TManish011/eYSIP_2015_Two_Wheel_Balance_Bot/README.md

# eYSIP_2015_Two_Wheel_Balance_Bot
Development of a self balancing two wheel bot using PID and IMU

The previous commits can be found at
[https://github.com/eySIP-balance-bot](https://github.com/eySIP-balance-bot)
