TManish011/eYSIP_2015_Two_Wheel_Balance_Bot/Application/Scilab/README.md

# Scilab

Real Time Plot and GUI for balance bot
--------------------------------------
PC Controlled Two Wheel Balanced Bot
------------------------------------
eYSIP-2015        
Author List: B Suresh, Ramiz Hussain, Devendra Kr Jangid     
Mentors: Piyush Manavar, Saurav Shandilya

A Scilab Interface was built for the purpose of tuning and controlling the 2 wheel Balance Bot
