TManish011/eYSIP_2015_Two_Wheel_Balance_Bot/Research/Balance-bot-1/Progress-Presentation/Progress-Presentation.pdf

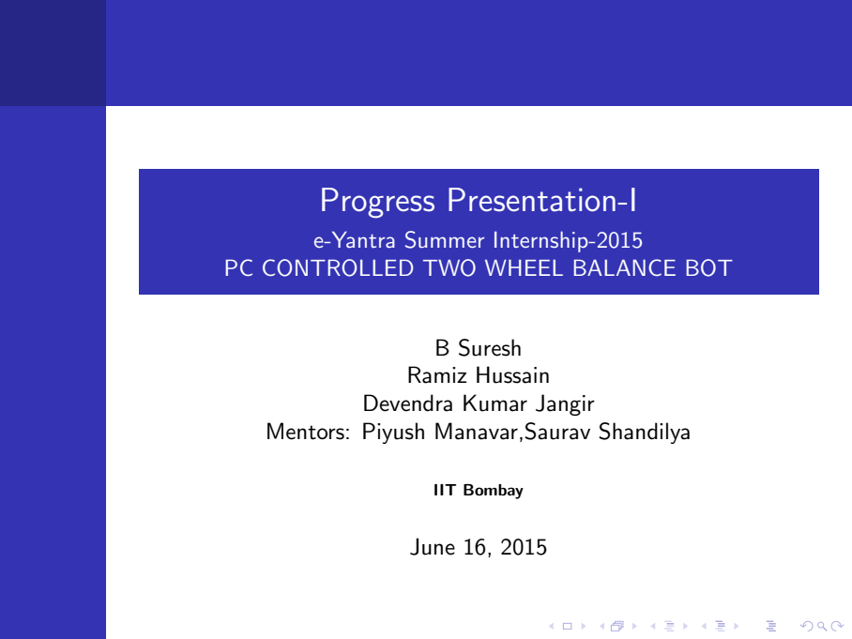
[picture p14: figure]
Progress Presentation-I; e-Yantra Summer Internship-2015 PC CONTROLLED TWO WHEEL BALANCE BOT; B Suresh Ramiz Hussain Devendra Kumar Jangir; IIT Bombay; June 16, 2015

# Mentors: Piyush Manavar,Saurav Shandilya

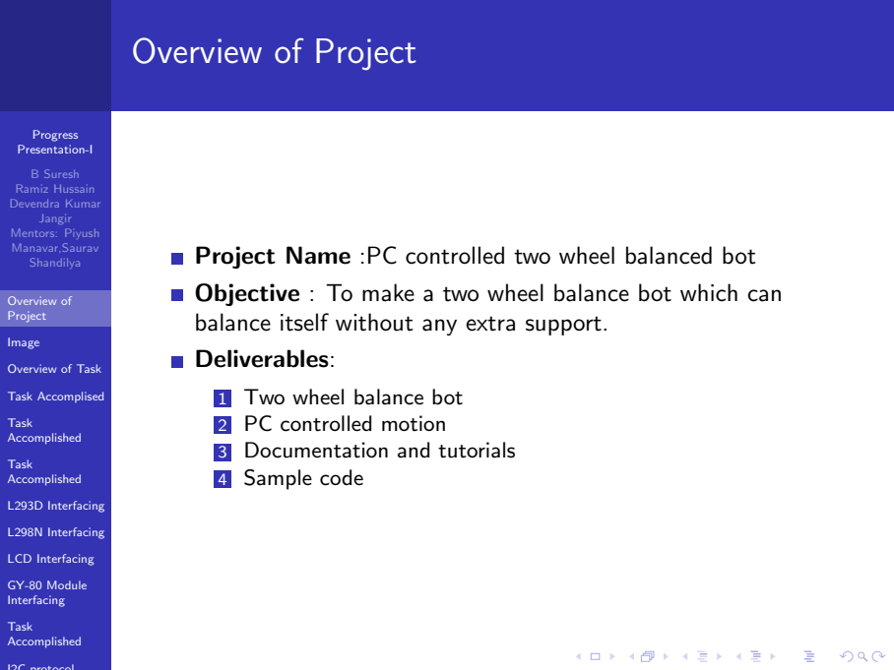
[picture p15: figure]
Progress Presentation-I; B Suresh Ramiz Hussain Devendra Kumar Jangir Mentors: Piyush Manavar,Saurav Shandilya; Overview of Project; Image; Overview of Task; Task Accomplised; Task Accomplished; L293D Interfacing; L298N Interfacing; LCD Interfacing; GY-80 Module Interfacing; I2C protocol; Deliverables:; Two wheel balance bot; PC controlled motion; Documentation and tutorials; Sample code

# Project Name :PC controlled two wheel balanced bot

# Objective : To make a two wheel balance bot which can

balance itself without any extra support.

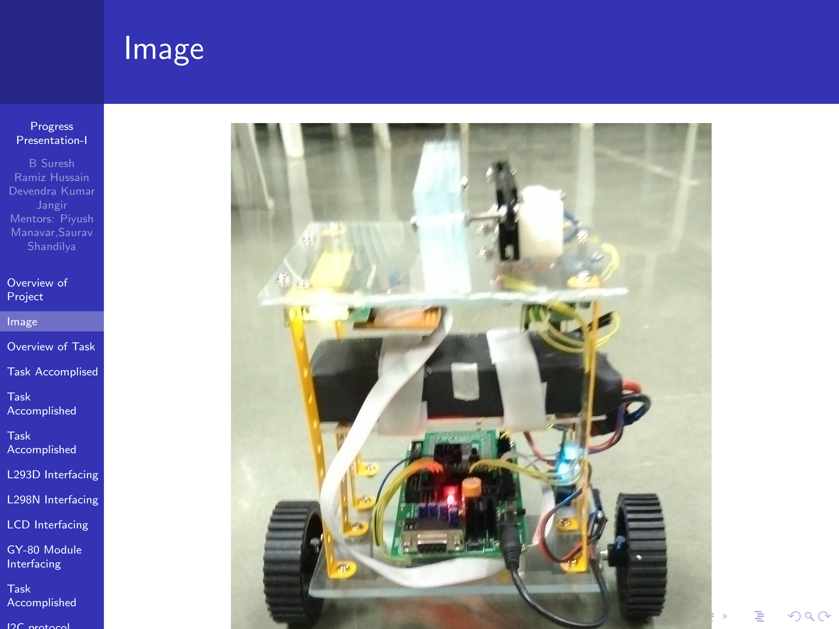
[picture p16: figure]
Progress Presentation-I; B Suresh Ramiz Hussain Devendra Kumar Jangir Mentors: Piyush Manavar,Saurav Shandilya; Overview of Project; Image; Overview of Task; Task Accomplised; Task Accomplished; L293D Interfacing; L298N Interfacing; LCD Interfacing; GY-80 Module Interfacing

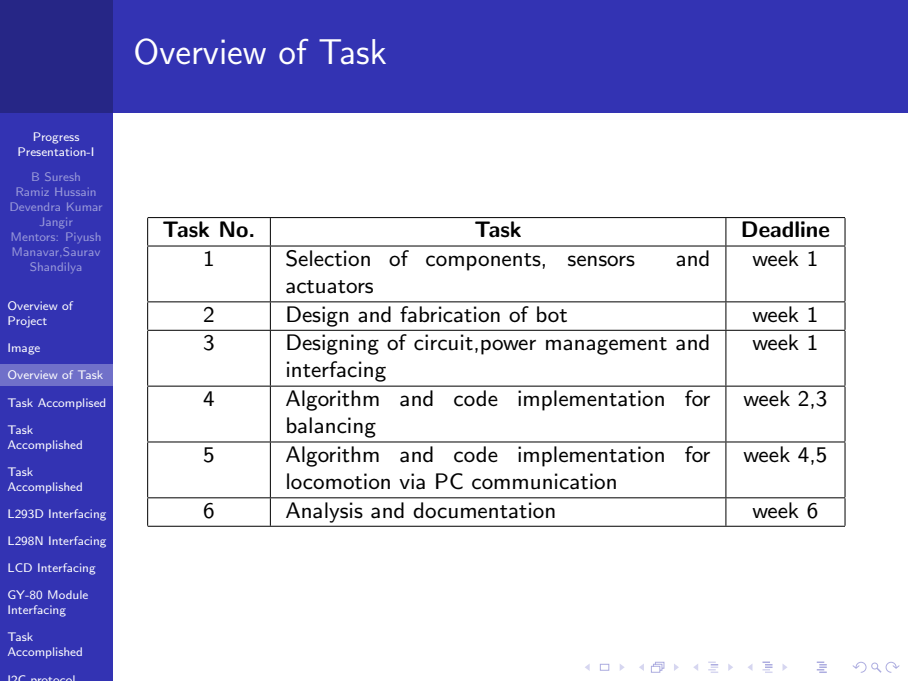
[picture p17: figure]
Progress Presentation-I; B Suresh Ramiz Hussain Devendra Kumar Jangir Mentors: Piyush Manavar,Saurav Shandilya; Overview of Project; Image; Overview of Task; Task Accomplised; Task Accomplished; L293D Interfacing; L298N Interfacing; LCD Interfacing; GY-80 Module Interfacing; Task No.; Task; Deadline; Design and fabrication of bot; week 1; Analysis and documentation; week 6

1 | Selection of components, sensors and actuators | week 1
3 | Designing of circuit,power management and interfacing | week 1
4 | Algorithm and code implementation for balancing | week 2,3
5 | Algorithm and code implementation for locomotion via PC communication | week 4,5

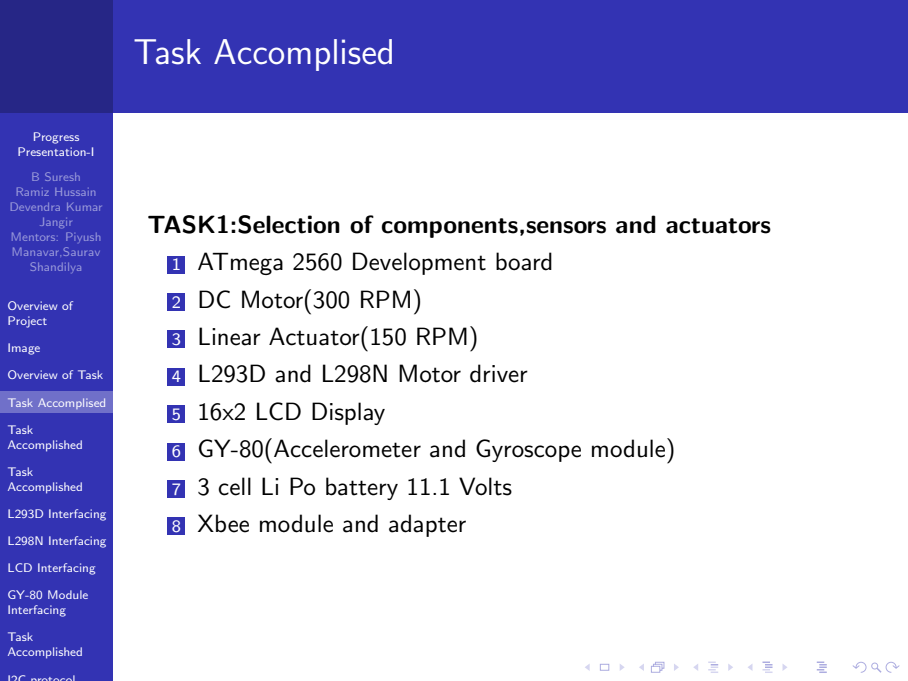
[picture p18: figure]
Progress Presentation-I; B Suresh Ramiz Hussain Devendra Kumar Jangir Mentors: Piyush Manavar,Saurav Shandilya; Overview of Project; Image; Overview of Task; Task Accomplised; Task Accomplished; L293D Interfacing; L298N Interfacing; LCD Interfacing; GY-80 Module Interfacing; ATmega 2560 Development board; DC Motor(300 RPM); Linear Actuator(150 RPM); L293D and L298N Motor driver; 16x2 LCD Display; 3 cell Li Po battery 11.1 Volts; Xbee module and adapter

# TASK1:Selection of components,sensors and actuators

# 6 GY-80(Accelerometer and Gyroscope module)

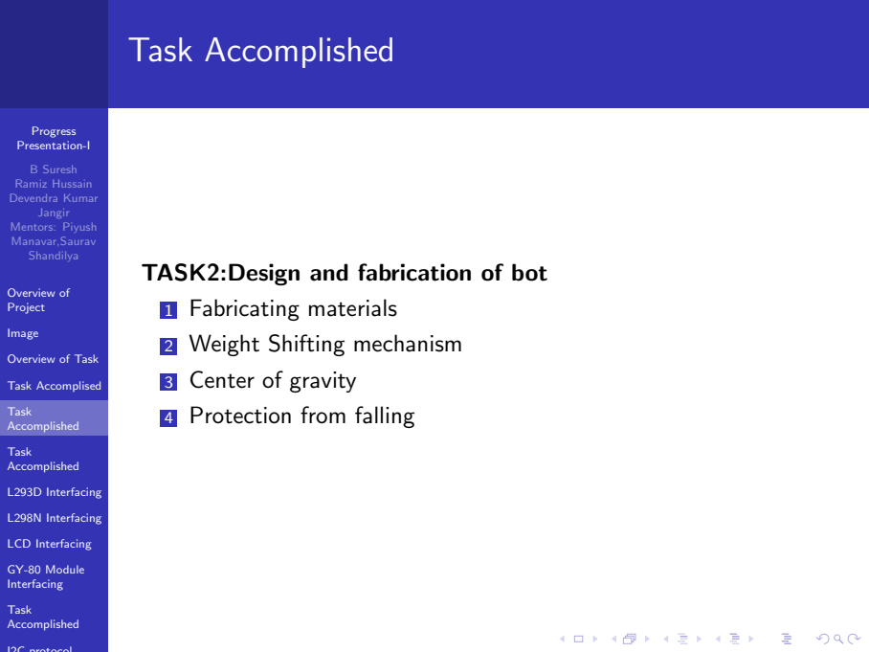
[picture p19: figure]
Progress Presentation-I; B Suresh Ramiz Hussain Devendra Kumar Jangir Mentors: Piyush Manavar,Saurav Shandilya; Overview of Project; Image; Overview of Task; Task Accomplised; Task Accomplished; L293D Interfacing; L298N Interfacing; LCD Interfacing; GY-80 Module Interfacing; TASK2:Design and fabrication of bot; Fabricating materials; Weight Shifting mechanism; Center of gravity; Protection from falling

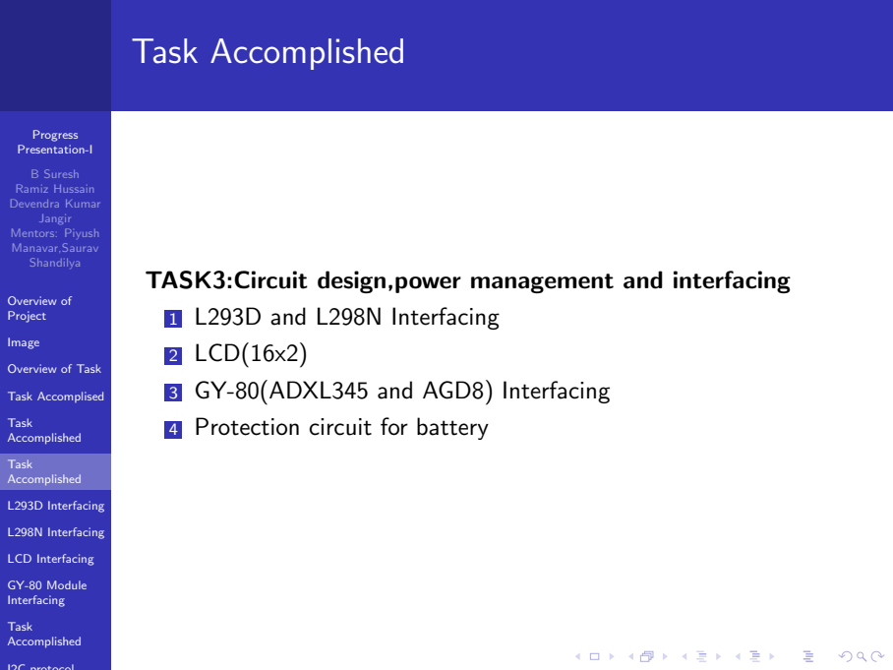
[picture p20: figure]
Progress Presentation-I; B Suresh Ramiz Hussain Devendra Kumar Jangir Mentors: Piyush Manavar,Saurav Shandilya; Overview of Project; Image; Overview of Task; Task Accomplised; Task Accomplished; L293D Interfacing; L298N Interfacing; LCD Interfacing; GY-80 Module Interfacing; L293D and L298N Interfacing; LCD(16x2); GY-80(ADXL345 and AGD8) Interfacing; Protection circuit for battery

# TASK3:Circuit design,power management and interfacing

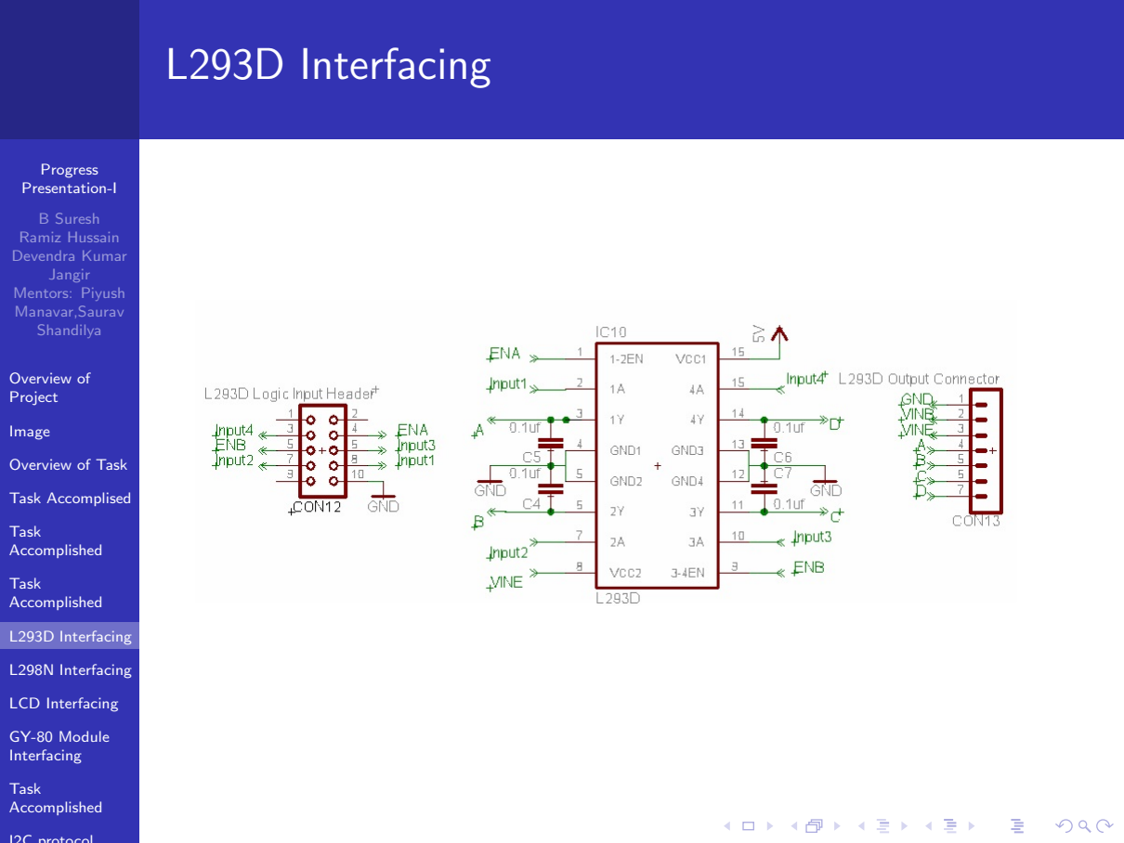
[picture p21: figure]
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

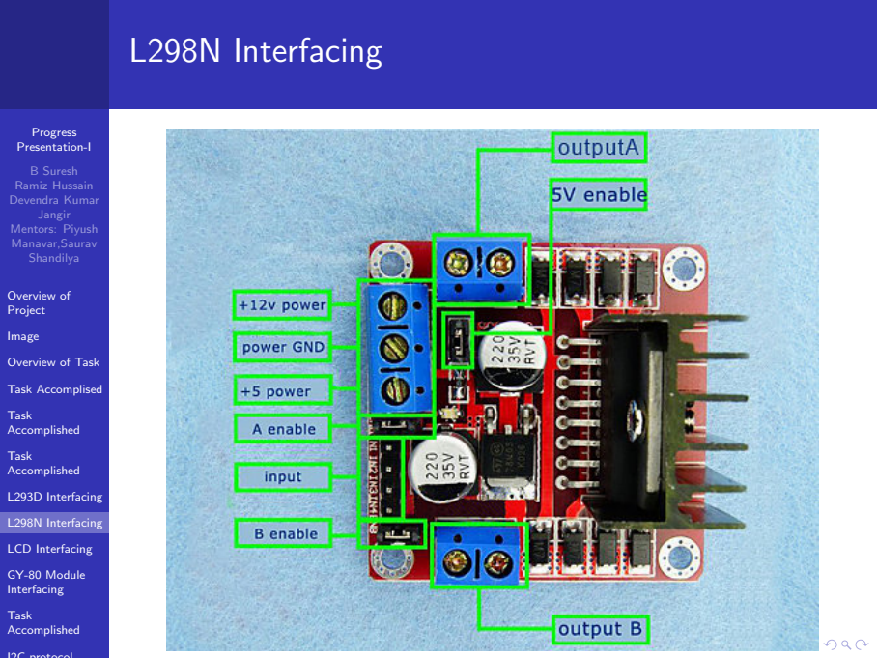
[picture p22: figure]
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

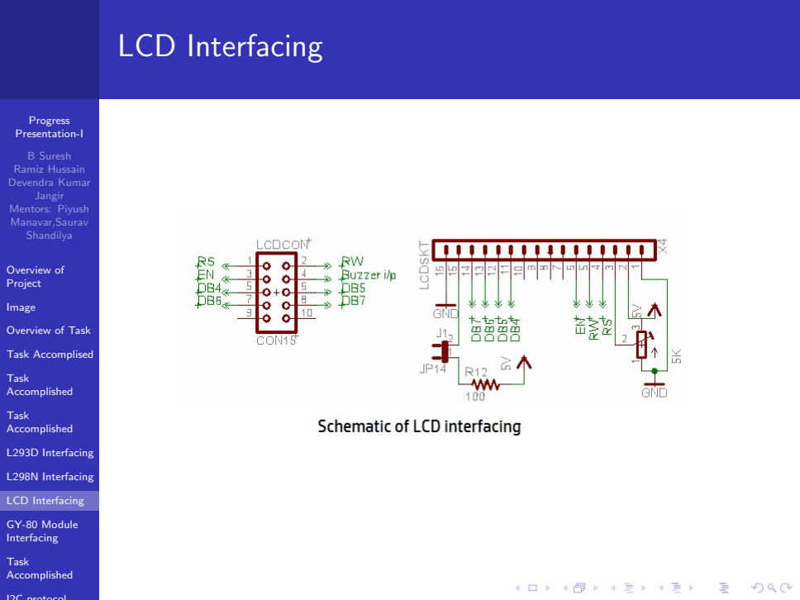
[picture p23: figure]
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

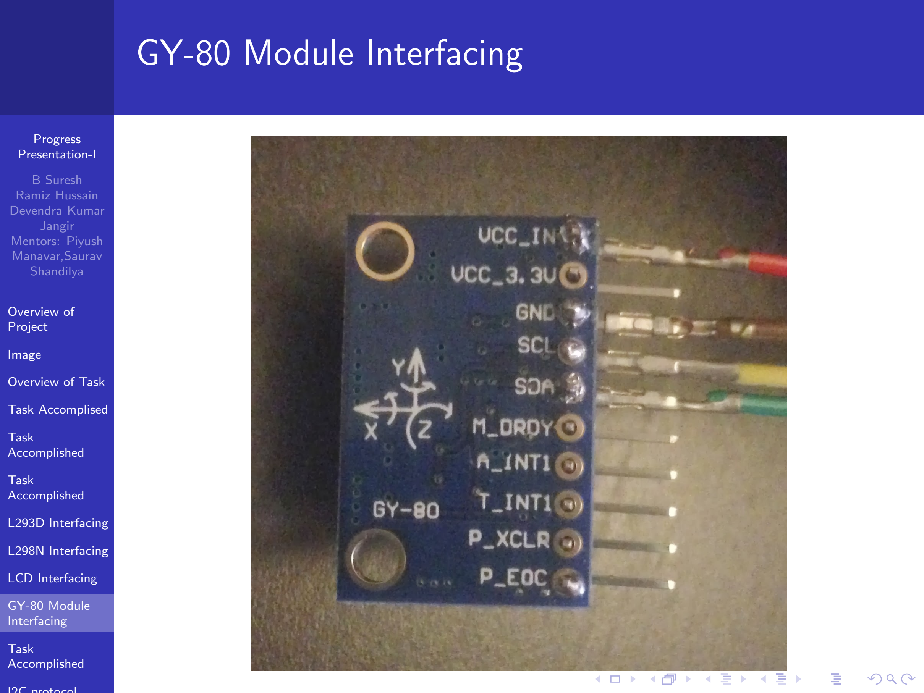
[picture p24: figure]
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

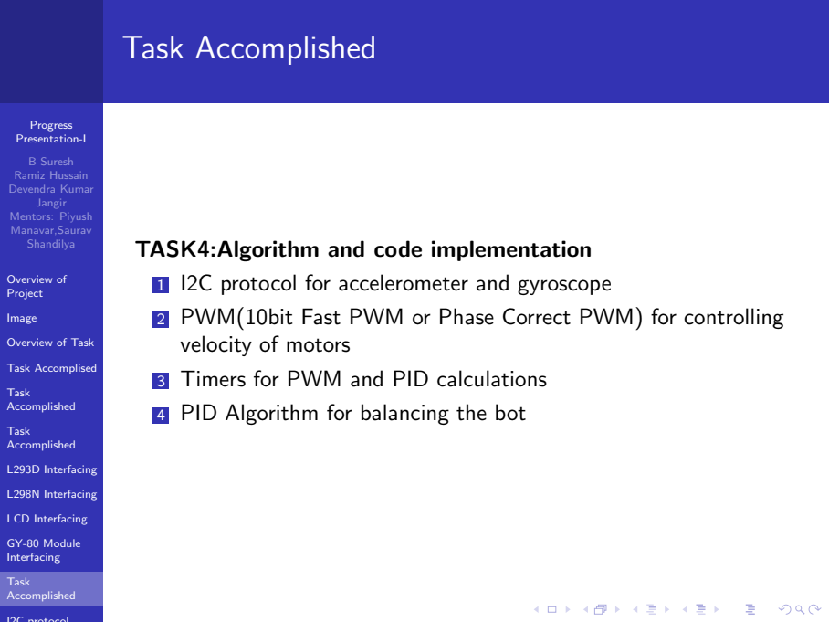
[picture p25: figure]
Progress Presentation-I; B Suresh Ramiz Hussain Devendra Kumar Jangir Mentors: Piyush Manavar,Saurav Shandilya; Overview of Project; Image; Overview of Task; Task Accomplised; Task Accomplished; L293D Interfacing; L298N Interfacing; LCD Interfacing; GY-80 Module Interfacing; TASK4:Algorithm and code implementation; velocity of motors; Timers for PWM and PID calculations; PID Algorithm for balancing the bot

1 | I2C protocol for accelerometer and gyroscope
2 | PWM(10bit Fast PWM or Phase Correct PWM) for controlling

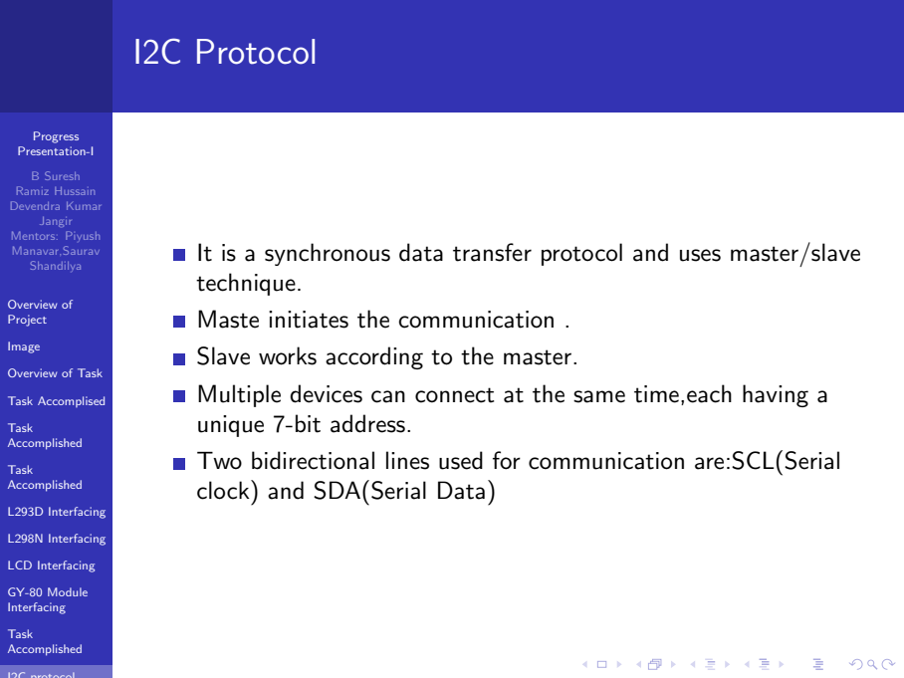
[picture p26: figure]
Progress Presentation-I; B Suresh Ramiz Hussain Devendra Kumar Jangir Mentors: Piyush Manavar,Saurav Shandilya; Overview of Project; Image; Overview of Task; Task Accomplised; Task Accomplished; L293D Interfacing; L298N Interfacing; LCD Interfacing; GY-80 Module Interfacing; I2C Protocol; technique.; Maste initiates the communication .; Slave works according to the master.; unique 7-bit address.; clock) and SDA(Serial Data)

# It is a synchronous data transfer protocol and uses master/slave

# Multiple devices can connect at the same time,each having a

# Two bidirectional lines used for communication are:SCL(Serial

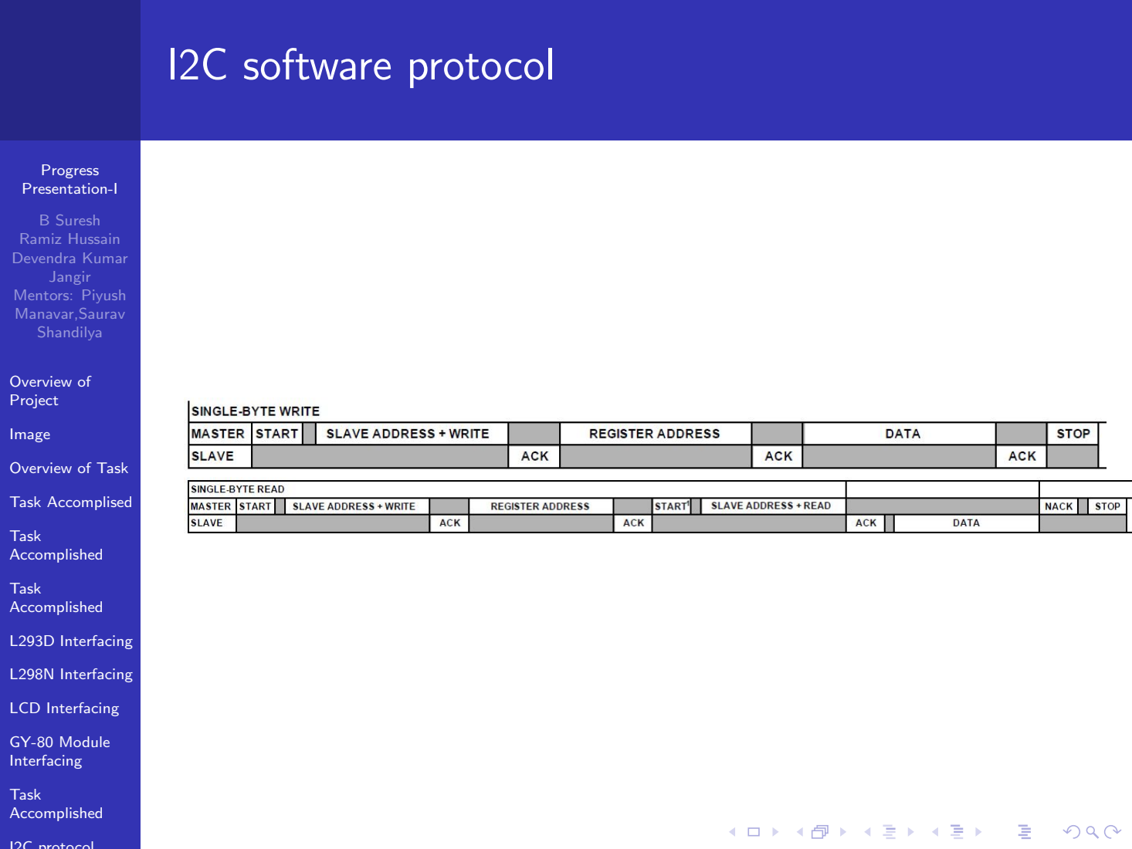
[picture p27: figure]
Progress Presentation-I; B Suresh Ramiz Hussain Devendra Kumar Jangir Mentors: Piyush Manavar,Saurav Shandilya; Overview of Project; Image; Overview of Task; Task Accomplised; Task Accomplished; L293D Interfacing; L298N Interfacing; LCD Interfacing; GY-80 Module Interfacing; I2C software protocol

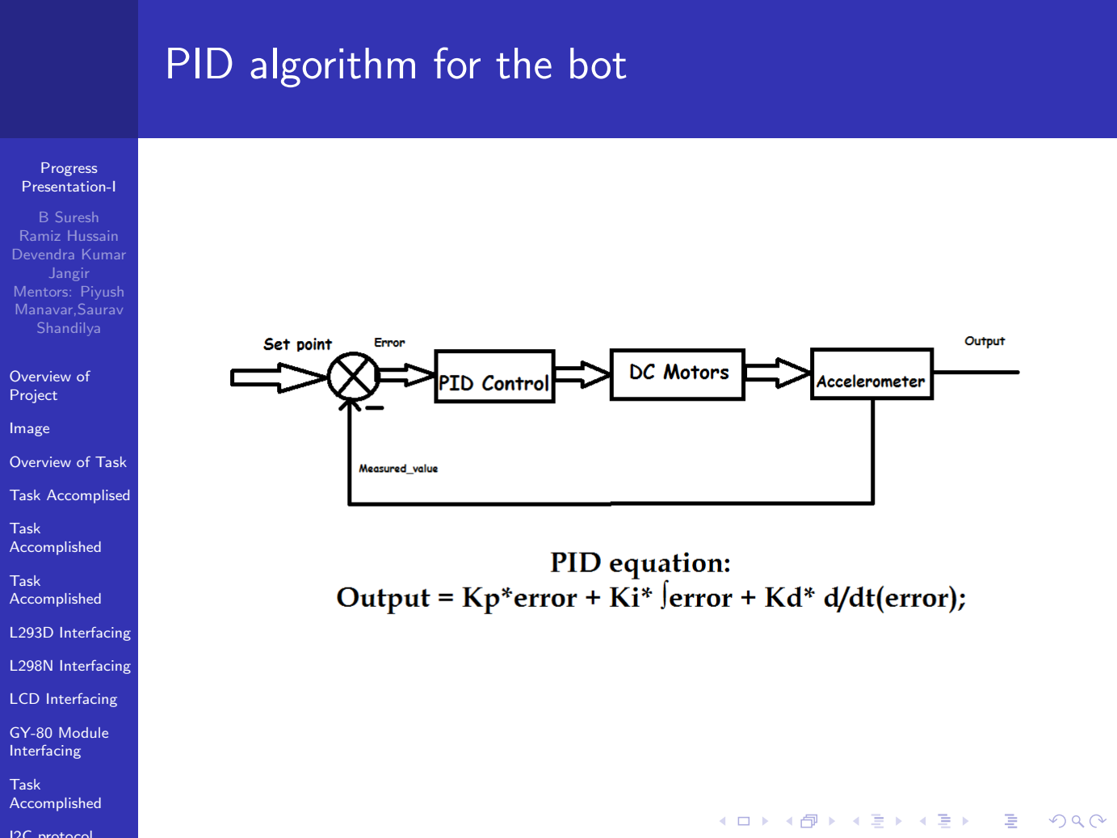
[picture p28: figure]
Progress Presentation-I; B Suresh Ramiz Hussain Devendra Kumar Jangir Mentors: Piyush Manavar,Saurav Shandilya; Overview of Project; Image; Overview of Task; Task Accomplised; Task Accomplished; L293D Interfacing; L298N Interfacing; LCD Interfacing; GY-80 Module Interfacing; PID algorithm for the bot

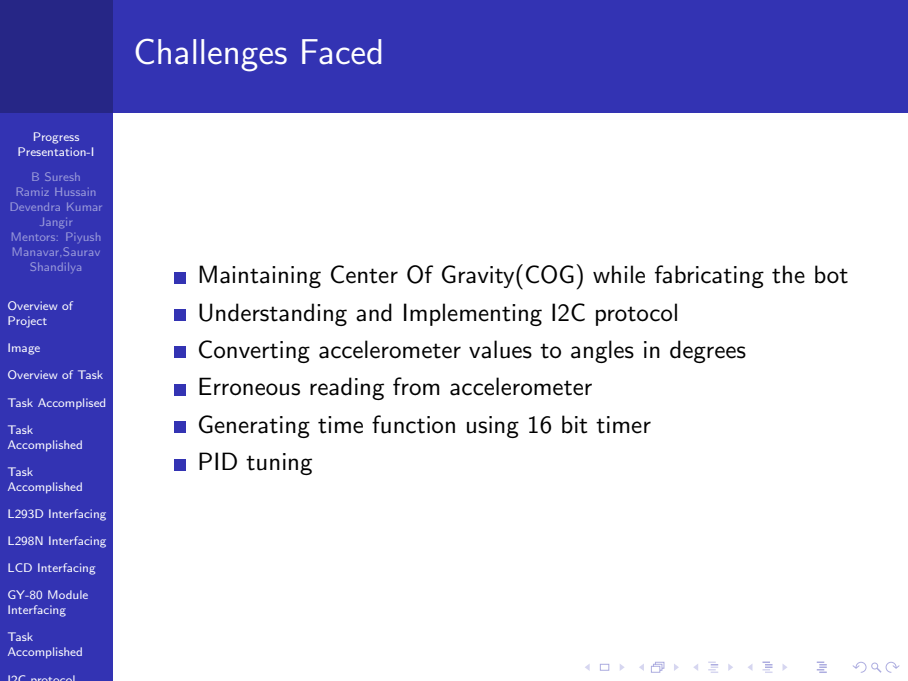
[picture p29: figure]
Progress Presentation-I; B Suresh Ramiz Hussain Devendra Kumar Jangir Mentors: Piyush Manavar,Saurav Shandilya; Overview of Project; Image; Overview of Task; Task Accomplised; Task Accomplished; L293D Interfacing; L298N Interfacing; LCD Interfacing; GY-80 Module Interfacing; Challenges Faced; Erroneous reading from accelerometer; PID tuning

# Maintaining Center Of Gravity(COG) while fabricating the bot

# Understanding and Implementing I2C protocol

# Converting accelerometer values to angles in degrees

# Generating time function using 16 bit timer

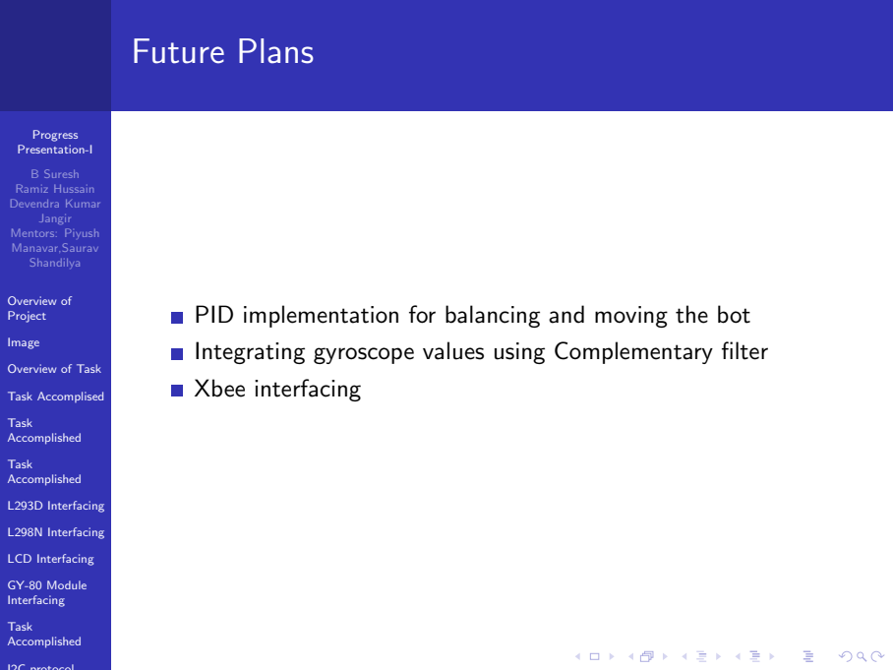
[picture p30: figure]
Progress Presentation-I; B Suresh Ramiz Hussain Devendra Kumar Jangir Mentors: Piyush Manavar,Saurav Shandilya; Overview of Project; Image; Overview of Task; Task Accomplised; Task Accomplished; L293D Interfacing; L298N Interfacing; LCD Interfacing; GY-80 Module Interfacing; Future Plans; Xbee interfacing

# PID implementation for balancing and moving the bot

# Integrating gyroscope values using Complementary filter

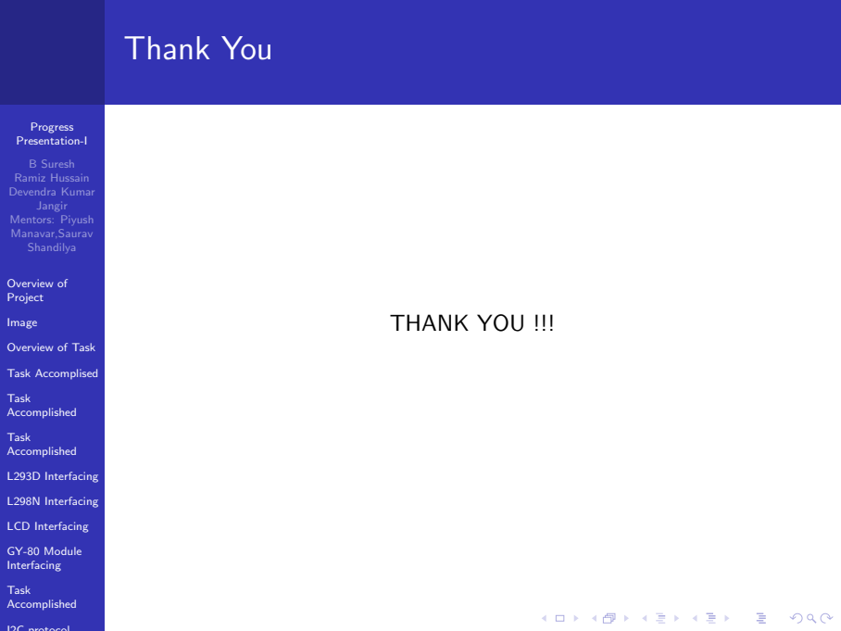
[picture p31: figure]
Progress Presentation-I; B Suresh Ramiz Hussain Devendra Kumar Jangir Mentors: Piyush Manavar,Saurav Shandilya; Overview of Project; Image; Overview of Task; Task Accomplised; Task Accomplished; L293D Interfacing; L298N Interfacing; LCD Interfacing; GY-80 Module Interfacing; Thank You; THANK YOU !!!
