TManish011/eYSIP_2015_Two_Wheel_Balance_Bot/Research/Balance-bot-1/images/pid_p_8.JPG

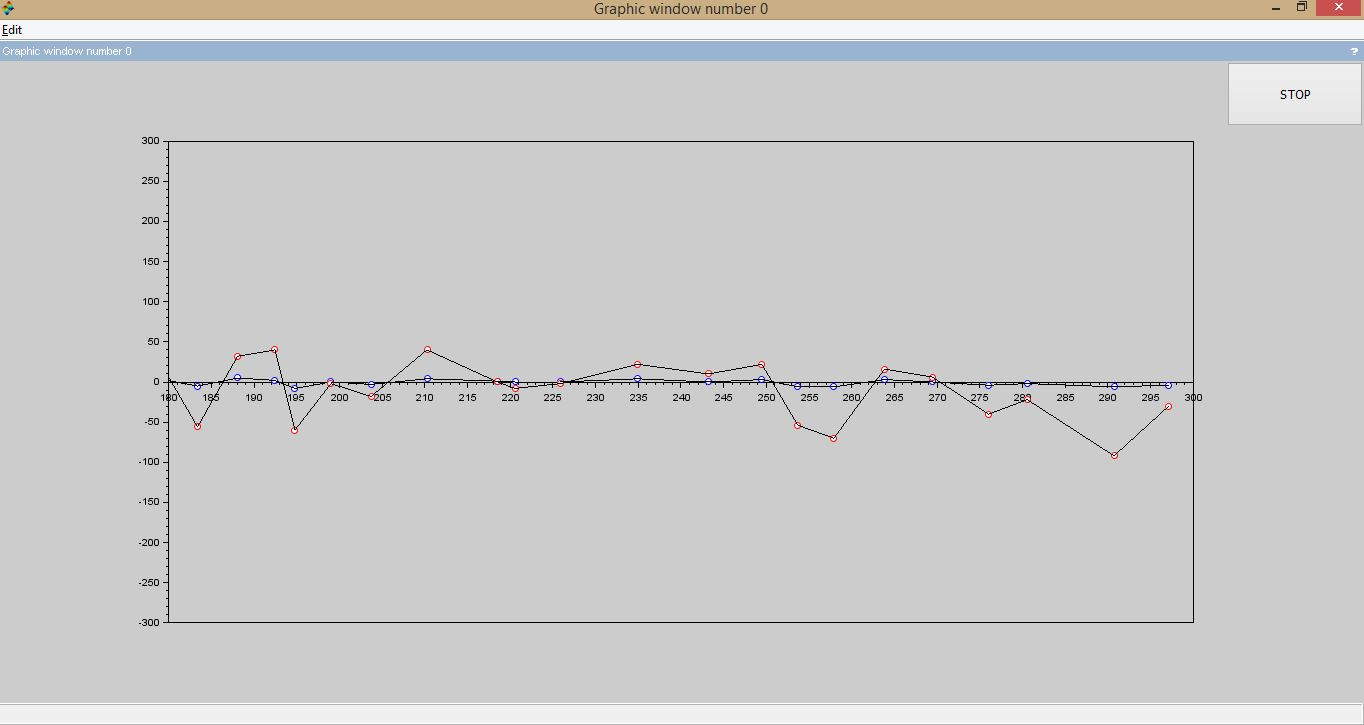
Research/Balance-bot-1/images/pid_p_8.JPG
