TManish011/eYSIP_2015_Two_Wheel_Balance_Bot/Research/Balance-bot-1/images/Team.jpg

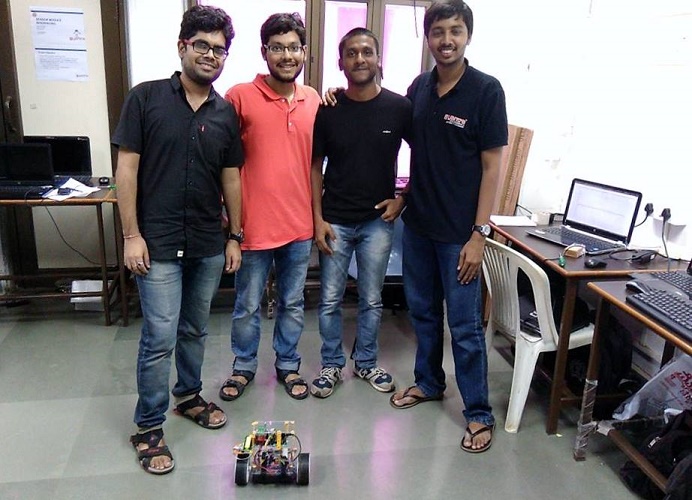
Research/Balance-bot-1/images/Team.jpg
