TManish011/eYSIP_2015_Two_Wheel_Balance_Bot/Research/test1/TcfTransactionLog.csv

Service | Message | Max | Min | Average | Count | frequency | TimedOut
Stream | setLogBits | 45.0026 | 45.0026 | 45.0026 | 1 | 0
