TManish011/eYSIP_2015_Two_Wheel_Balance_Bot/Research/test1/New folder/TcfTransactionLog.csv

Service | Message | Max | Min | Average | Count | frequency | TimedOut
Stream | setLogBits | 28.0016 | 28.0016 | 28.0016 | 1 | 0
