TManish011/eYSIP_2015_Two_Wheel_Balance_Bot/Research/test1/PID_test1/TcfTransactionLog.csv

Service | Message | Max | Min | Average | Count | frequency | TimedOut
Stream | setLogBits | 27.0015 | 27.0015 | 27.0015 | 1 | 0
