TManish011/eYSIP_2015_Two_Wheel_Balance_Bot/Research/test1/6_Velocity_Control_using_PWM/6_Velocity_Control_using_PWM/TcfTransactionLog.csv

Service | Message | Max | Min | Average | Count | frequency | TimedOut
Stream | setLogBits | 31.2001 | 31.2001 | 31.2001 | 1 | 0
