TManish011/eYSIP_2015_Two_Wheel_Balance_Bot/Research/Balance-bot-1/test1/test1/test1.c

/********************************************************************************
 Platform: ATMEGA2560 Development Board
 Experiment: Serial communication
 Written by: Vinod Desai, NEX Robotics Pvt. Ltd.
 Edited By: Sachitanand Malewar, NEX Robotics Pvt. Ltd.
 Last Modification: 08th May 2012
 AVR Studio Version 4.17, Build 666

 Concepts covered: Two wire(I2C) interfacing with DS1037 
 
 This program demonstrate the interfacing of External RTC (DS1307) with the microcontroller via I2C bus.
 Values from the RTC are displayed on the LCD.

 Hardware Setup: (Ref. Fig. 3.21 from chapter 3)
 Connect the jumpers at SCL and SDA lines at the I2C Header to interface DS1307 with the microcontroller.
 For more details refer to section 3.11

 Refer product manual for more detailed description.

 Note: 
 
 1. Make sure that in the configuration options following settings are 
 	done for proper operation of the code

 	Microcontroller: ATMEGA2560
 	Frequency: 14745600Hz
 	Optimization: -O0 (For more information refer to the section below figure 2.22 in the product manual)

 2. Include lcd.c file in the same project file.

*********************************************************************************/
#define F_CPU 14745600

#include <avr/io.h>
#include <avr/interrupt.h>
#include <util/delay.h>
#include <math.h>

#include "lcd.c"
#include "timer.h"

#define	SLA_W	0xA6             // Write address for DS1307 selection for writing	
#define	SLA_R	0xA7             // Write address for DS1307 selection for reading  

//------------------------------------------------------------------------------
// define ADXL345 register addresses
//------------------------------------------------------------------------------
#define X1	 0x32            
#define X2 	 0x33
#define Y1 	 0x34
#define Y2   0x35
#define Z1 	 0x36
#define Z2   0x37




//------------------------------------------------------------------------------
//Function to configure LCD port
void lcd_port_config (void)
{
 DDRC = DDRC | 0xF7;      //all the LCD pin's direction set as output
 PORTC = PORTC & 0x80;    // all the LCD pins are set to logic 0 except PORTC 7
}

//------------------------------------------------------------------------------
// I2C Peripheral Function Prototypes
//------------------------------------------------------------------------------
//------------------------------------------------------------------------------
// I2C initilise
//------------------------------------------------------------------------------

//TWI initialize
// bit rate:72
void twi_init(void)
{
 TWCR = 0x00;   //disable twi
 TWBR = 0x10; //set bit rate
 TWSR = 0x00; //set prescale
 TWAR = 0x00; //set slave address
 TWCR = 0x04; //enable twi
}

//------------------------------------------------------------------------------
// Procedure:	write_byte 
// Inputs:		data out, address
// Outputs:		none
// Description:	Writes a byte to the RTC given the address register 
//------------------------------------------------------------------------------
void write_byte(unsigned char data_out,unsigned char address)
{
 TWCR = (1<<TWINT) | (1<<TWSTA) | (1<<TWEN);       // send START condition  
 while(!(TWCR & (1<<TWINT)));                      // wait for TWINT Flag set
 _delay_ms(10);                                    

 TWDR = SLA_W;                                     // load SLA_W into TWDR Register
 TWCR  = (1<<TWINT) | (0<<TWSTA) | (1<<TWEN);      // clear TWINT flag to start tramnsmission of slave address 
 while(!(TWCR & (1<<TWINT)));                      // wait for TWINT Flag set
 _delay_ms(10);

 TWDR = address;                                   // send address of register byte want to access register
 TWCR  = (1<<TWINT) | (1<<TWEN);                   // clear TWINT flag to start tramnsmission of address 
 while(!(TWCR & (1<<TWINT)));                      // wait for TWINT Flag set
 _delay_ms(10);

 TWDR = data_out;                       // convert the character to equivalent BCD value and load into TWDR
 TWCR  = (1<<TWINT) | (1<<TWEN);                   // clear TWINT flag to start tramnsmission of data byte
 while(!(TWCR & (1<<TWINT)));                      // wait for TWINT Flag set
 _delay_ms(10);

 TWCR = (1<<TWINT) | (1<<TWSTO) | (1<<TWEN);       // send STOP condition
}

//------------------------------------------------------------------------------
// Procedure:	read_byte 
// Inputs:		address
// Outputs:		none
// Description:	read a byte from the RTC from send the address register 
//------------------------------------------------------------------------------
unsigned char read_byte(unsigned char address)
{  
 unsigned char rtc_recv_data;

 
TWCR = (1<<TWINT) | (1<<TWSTA) | (1<<TWEN);      // send START condition  
while(!(TWCR & (1<<TWINT)));                      // wait for TWINT Flag set
 //_delay_ms(10);

 

 TWDR = SLA_W;									   // load SLA_W into TWDR Register
 TWCR  = (1<<TWINT) | (1<<TWEN);                   // clear TWINT flag to start tramnsmission of slave address 
 while(!(TWCR & (1<<TWINT)));                      // wait for TWINT Flag set
 //_delay_ms(10); 

 TWDR = address;                                   // send address of register byte want to access register
 TWCR  = (1<<TWINT) | (1<<TWEN);                   // clear TWINT flag to start tramnsmission of slave address 
 while(!(TWCR & (1<<TWINT)));                      // wait for TWINT Flag set
 //_delay_ms(10);
 


 TWCR = (1<<TWINT) | (1<<TWSTA) | (1<<TWEN);       // send RESTART condition
 while(!(TWCR & (1<<TWINT)));                      // wait for TWINT Flag set
 //_delay_ms(10);


 
 TWDR = SLA_R;									   // load SLA_R into TWDR Register
 TWCR  = (1<<TWINT) | (0<<TWSTA) | (1<<TWEN);      // clear TWINT flag to start tramnsmission of slave address 
 while(!(TWCR & (1<<TWINT)));                      // wait for TWINT Flag set
 //_delay_ms(10);
 
 

 TWCR  = (1<<TWINT) | (1<<TWEN);                   // clear TWINT flag to read the addressed register
 while(!(TWCR & (1<<TWINT)));                      // wait for TWINT Flag set
 rtc_recv_data = TWDR;
 //_delay_ms(10);
 
 TWDR = 00;                                        // laod the NO-ACK value to TWDR register 
 TWCR  = (1<<TWINT) | (1<<TWEN);                   // clear TWINT flag to start tramnsmission of NO_ACK signal
 while(!(TWCR & (1<<TWINT)));                      // wait for TWINT Flag set
 //_delay_ms(10);
  
 return(rtc_recv_data);                            // return the read value to called function
}

//------------------------------------------------------------------------------
// initialise the diaplay format  
//------------------------------------------------------------------------------
void display_format_init(void)
{
 lcd_cursor (1, 1);
 lcd_string("  :  :  ");  
}

// initialise the devices 
void init_devices()
{
 cli();              // disable all interrupts 
 lcd_port_config();  // configure the LCD port 
 twi_init();         // configur the I2cC, i.e TWI module 
 sei();              // re-enable interrupts
 //all peripherals are now initialized
}

void pr_int(int a,int b,int c,int d) /* get negative values*/
{
	if (c<0)
	{
		lcd_cursor(a,b);
		lcd_string("-");
		lcd_print(a,b+1,abs(c),d);
	} 
	else
	{
		lcd_cursor(a,b);
		lcd_string("+");
		lcd_print(a,b+1,c,d);
	}
}

int sign (unsigned int n)
{
	if (n>32767)
	{
		return (n-65536);
	}
	else
		return n;
		
}
//-------------------------------------------------------------------------------
// Main Programme start here.
//-------------------------------------------------------------------------------
int main(void)
{   
  uint16_t x_byte = 0,y_byte = 0,z_byte = 0;
  uint8_t x_byte1 = 0x88,x_byte2 = 0x88,y_byte1 = 0,y_byte2 = 0,z_byte1 = 0,z_byte2 = 0;
  int x_acc,y_acc,z_acc;
  //long x,y,z;
  float angle;

 init_devices();
 lcd_set_4bit();                // set the LCD in 4 bit mode
 lcd_init();                    // initialize the LCD with its commands
 display_clear();               // clear the LCD

	write_byte(0x0,0x2D);
	write_byte(0x8,0x2D);
 
while(1)
{
	   
	   start_timer4();
	   x_byte1 = read_byte(X1);
	   //x_byte1=(x_byte1*1000)/256;
	   
	   
	   
	   x_byte2 = read_byte(X2);
	   //lcd_print(2,1,abs(x_byte2),3);
	   
	   y_byte1 = read_byte(Y1);
	   //lcd_print(1,6,y_byte1,3);
	   
	   y_byte2 = read_byte(Y2);
	   //lcd_print(2,6,y_byte2,3);
	   
	   z_byte1 = read_byte(Z1);
	   //lcd_print(1,10,z_byte1,3);
	   
	   z_byte2 = read_byte(Z2);
	   //lcd_print(2,10,z_byte2,3);
	    
	   //x_byte2 &= 0x03;
	  
	  x_byte=x_byte2;
	  x_byte = (x_byte << 8);
	  x_byte |= x_byte1;
	  x_acc=sign(x_byte);
	  
	  //pr_int(1,1,x_byte,3); 
	  
	  y_byte=y_byte2;
	  y_byte = (y_byte << 8);
	  y_byte |= y_byte1;
	  y_acc=sign(y_byte);
	  
	  //pr_int(2,5,y_byte,3); 	
	  
	  z_byte=z_byte2;
	  z_byte = (z_byte << 8);
	  z_byte |= z_byte1;
	  z_acc=sign(z_byte);
	  
	  
	  //pr_int(1,10,z_byte,3);  
	  
	  angle=(atan((y_acc*1.0)/(z_acc*1.0)));
	  angle *= 180.0/3.14;
	  lcd_print(2,1,millis(),4);
	  start_timer4();
	  pr_int(1,1,angle,3);
	  
	  lcd_print(2,6,millis(),4);
	  /*if(x_byte2 & (1 << 1))	
		{	
			lcd_cursor(1, 1);
			lcd_string("-");
			lcd_print(1,2,(x_byte - 512),5);
		}
	  //lcd_print(1,1,x_byte,5);
	  else
		lcd_print(1,1,x_byte,5);
	  
	  //lcd_print(2,1,read_byte(0x31),3);
	  
	  y_byte2 &= 0x03;
	  y_byte=y_byte2;
	  y_byte=((y_byte<<8) | y_byte1);
	  pr_int(2,5,y_byte,5);
	  
	   z_byte2 &= 0x03;
	  z_byte=z_byte2;
	  z_byte=((z_byte<<8) | z_byte1);
	  pr_int(1,10,z_byte,5);
	  */
}
}

//--------------------------------------------------------------------------------
