TManish011/eYSIP_2015_Two_Wheel_Balance_Bot/Research/Balance-bot-1/test1/test1/timer.h

// global variable to count the number of overflows
volatile uint8_t tot_overflow;


void timer4_init(void)
{
	tot_overflow=0;
	TCCR4B = 0x00; //stop
	TCNT4H = 0x1F; //Counter higher 8 bit value
	TCNT4L = 0x01; //Counter lower 8 bit value
	OCR4AH = 0x00; //Output compare Register (OCR)- Not used
	OCR4AL = 0x00; //Output compare Register (OCR)- Not used
	OCR4BH = 0x00; //Output compare Register (OCR)- Not used
	OCR4BL = 0x00; //Output compare Register (OCR)- Not used
	OCR4CH = 0x00; //Output compare Register (OCR)- Not used
	OCR4CL = 0x00; //Output compare Register (OCR)- Not used
	ICR4H  = 0x00; //Input Capture Register (ICR)- Not used
	ICR4L  = 0x00; //Input Capture Register (ICR)- Not used
	TCCR4A = 0x00;
	TCCR4C = 0x00;
	TCCR4B = 0x04; //start Timer
}

// TIMER4 overflow interrupt service routine
// called whenever TCNT4 overflows
ISR(TIMER4_OVF_vect)
{
	// keep a track of number of overflows
	tot_overflow++;
	//TIMER4 has overflowed
	TCNT4H = 0x1F; //reload counter high value
	TCNT4L = 0x01; //reload counter low value
}

void start_timer4(void)
{
	cli(); //Clears the global interrupts
	timer4_init();
	TIMSK4 = 0x01; //timer4 overflow interrupt enable
	sei();   //Enables the global interrupts
	
}

int millis(void)
{
	int time=0;	
	time=1000*(tot_overflow + (TCNT4-7936.0)/57598);
	start_timer4();
	return time;
	
}
